SurrealityLabs/tn_vdp/KiCad/tn_vdp_v1_compact_vga_cable/tn_vdp_v1_compact_vga_cable.pdf

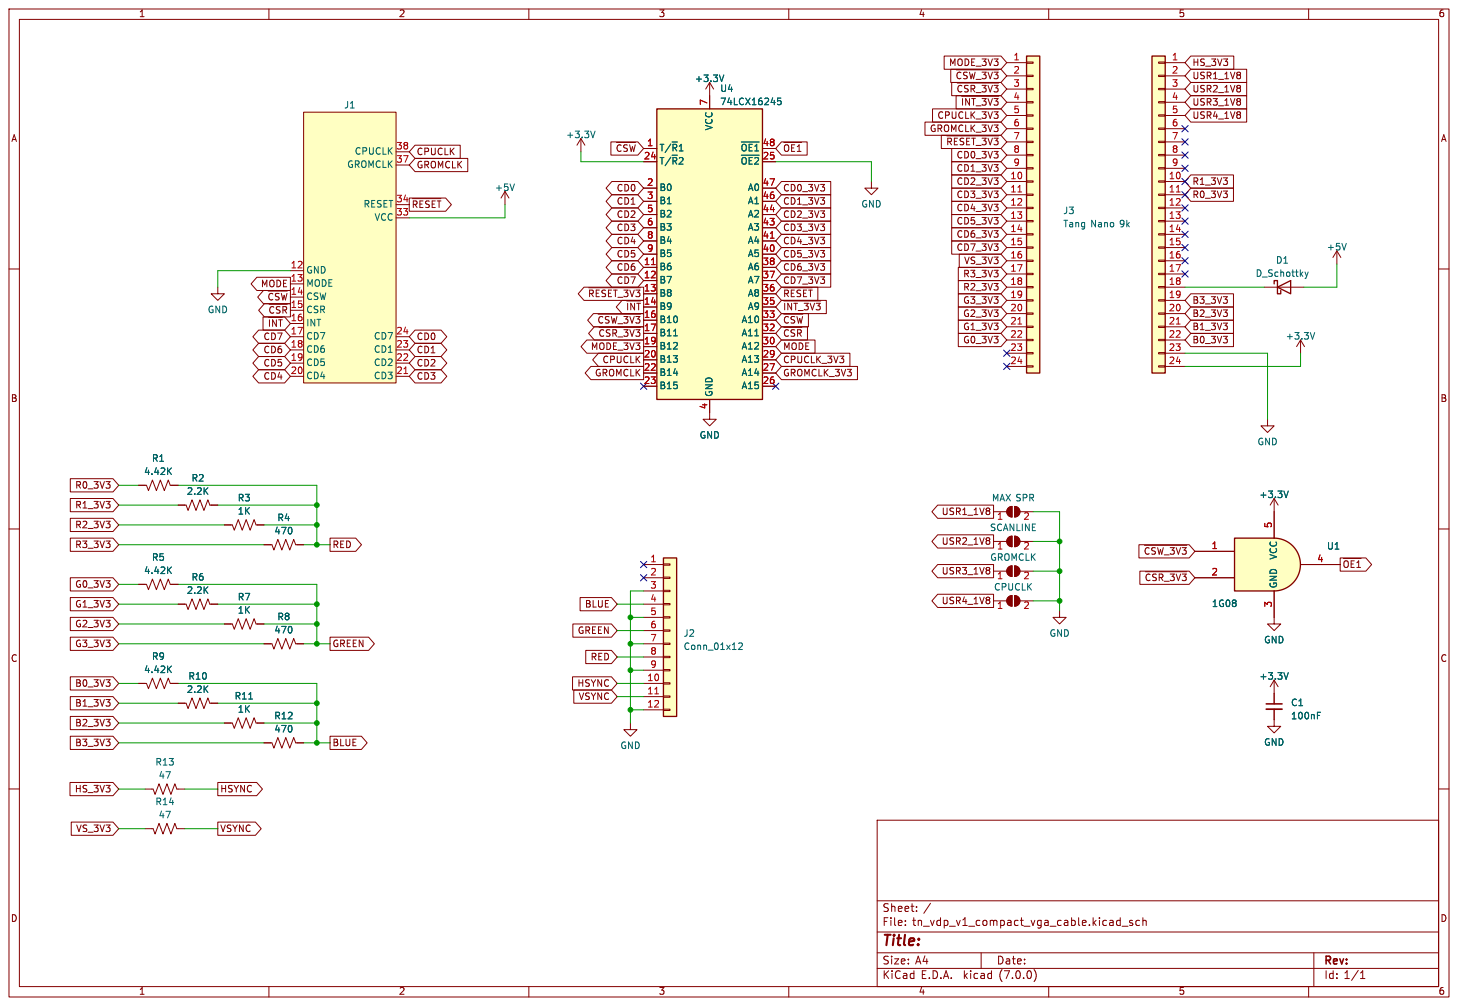
[picture p1: page 1]

Id: 1/1 Title: File: tn_vdp_v1_compact_vga_cable.kicad_sch Sheet: / R2
