SurrealityLabs/tn_vdp/KiCad/tn_vdp_v1_compact_vga_cable/tn_vdp_v1_compact_vga_cable.kicad_pcb

## KiCad design KiCad/tn_vdp_v1_compact_vga_cable/tn_vdp_v1_compact_vga_cable.kicad_pcb (2023-06-11)

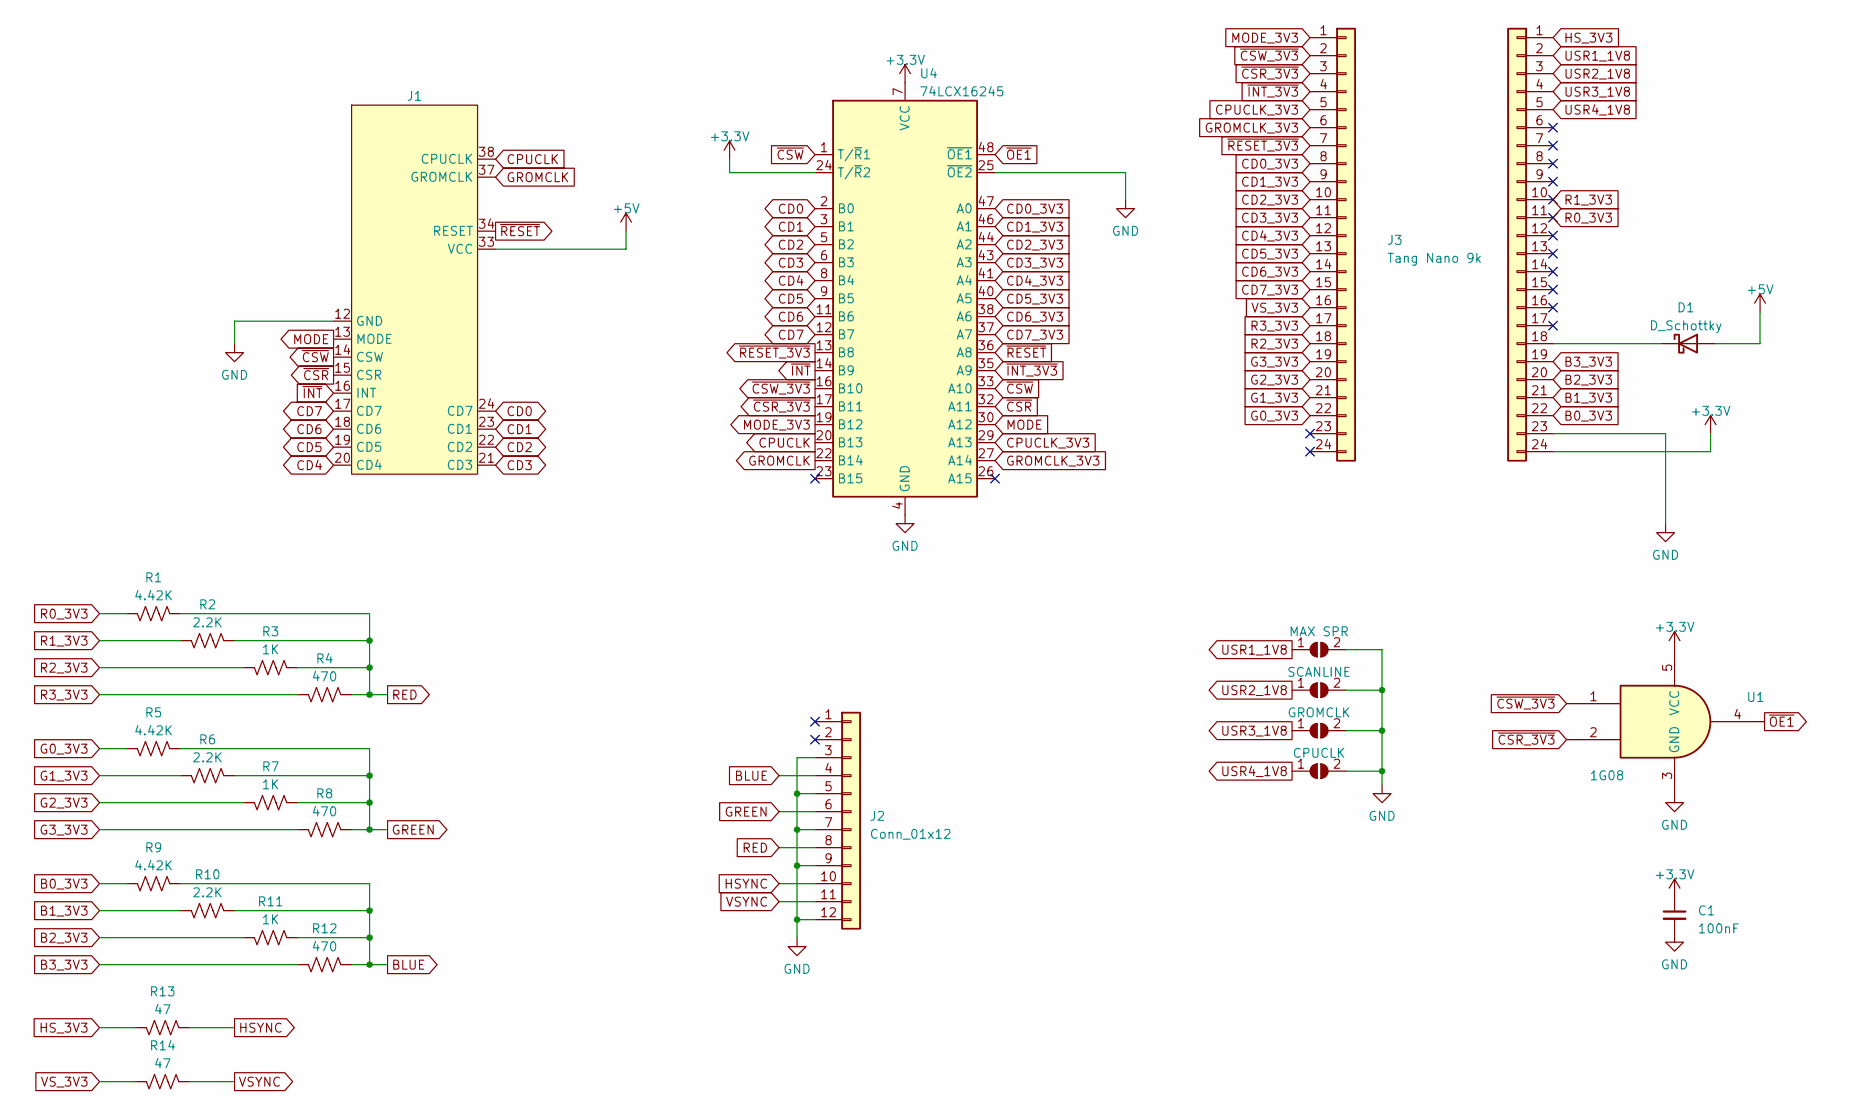
[picture p2: schematic tn_vdp_v1_compact_vga_cable.kicad_sch]

Parts:
C1: 100nF; C_0603_1608Metric_Pad1.08x0.95mm_HandSolder; LCSC C2857981
D1: D_Schottky; D_SOD-123; LCSC C2900723
J1: TMS99xxA_Replacement
J2: Conn_01x12; JST_PH_B12B-PH-K_1x12_P2.00mm_Vertical
J3: Tang Nano 9k; PinSocket_1x24_P2.54mm_Vertical
J4: TN9k/2; PinSocket_1x24_P2.54mm_Vertical
JP1: MAX SPR; SolderJumper-2_P1.3mm_Open_RoundedPad1.0x1.5mm
JP2: SCANLINE; SolderJumper-2_P1.3mm_Open_RoundedPad1.0x1.5mm
JP3: GROMCLK; SolderJumper-2_P1.3mm_Open_RoundedPad1.0x1.5mm
JP4: CPUCLK; SolderJumper-2_P1.3mm_Open_RoundedPad1.0x1.5mm
R1, R5, R9: 4.42K; R_0603_1608Metric_Pad0.98x0.95mm_HandSolder; LCSC C5140130
R2, R6, R10: 2.2K; R_0603_1608Metric_Pad0.98x0.95mm_HandSolder; LCSC C3016472
R3, R7, R11: 1K; R_0603_1608Metric_Pad0.98x0.95mm_HandSolder; LCSC C3016283
R4, R8, R12: 470; R_0603_1608Metric_Pad0.98x0.95mm_HandSolder; LCSC C103660
R13, R14: 47; R_0603_1608Metric_Pad0.98x0.95mm_HandSolder; LCSC C3016437
U1: 1G08; SOT-23-5_HandSoldering; LCSC C7666
U4: 74LCX16245; TSSOP-48_6.1x12.5mm_P0.5mm; LCSC C894789

Connections:
+3.3V: C1.1, J4.24, U1.5 (VCC), U4.7 (VCC), U4.18 (VCC), U4.24 (T/~R2), U4.31 (VCC), U4.42 (VCC)
+5V: D1.2 (A), J1.33 (VCC)
B0_3V3: J4.22, R9.2
B1_3V3: J4.21, R10.2
B2_3V3: J4.20, R11.2
B3_3V3: J4.19, R12.2
BLUE: J2.4, R9.1, R10.1, R11.1, R12.1
CD0: J1.24 (CD7), U4.2 (B0)
CD0_3V3: J3.8, U4.47 (A0)
CD1: J1.23 (CD1), U4.3 (B1)
CD1_3V3: J3.9, U4.46 (A1)
CD2: J1.22 (CD2), U4.5 (B2)
CD2_3V3: J3.10, U4.44 (A2)
CD3: J1.21 (CD3), U4.6 (B3)
CD3_3V3: J3.11, U4.43 (A3)
CD4: J1.20 (CD4), U4.8 (B4)
CD4_3V3: J3.12, U4.41 (A4)
CD5: J1.19 (CD5), U4.9 (B5)
CD5_3V3: J3.13, U4.40 (A5)
CD6: J1.18 (CD6), U4.11 (B6)
CD6_3V3: J3.14, U4.38 (A6)
CD7: J1.17 (CD7), U4.12 (B7)
CD7_3V3: J3.15, U4.37 (A7)
CPUCLK: J1.38 (CPUCLK), U4.20 (B13)
CPUCLK_3V3: J3.5, U4.29 (A13)
G0_3V3: J3.22, R5.2
G1_3V3: J3.21, R6.2
G2_3V3: J3.20, R7.2
G3_3V3: J3.19, R8.2
GND: C1.2, J1.12 (GND), J2.3, J2.5, J2.7, J2.9, J2.12, J4.23, JP1.2 (B), JP2.2 (B), JP3.2 (B), JP4.2 (B), U1.3 (GND), U4.4 (GND), U4.10 (GND), U4.15 (GND), U4.21 (GND), U4.25 (~OE2), U4.28 (GND), U4.34 (GND), U4.39 (GND), U4.45 (GND)
GREEN: J2.6, R5.1, R6.1, R7.1, R8.1
GROMCLK: J1.37 (GROMCLK), U4.22 (B14)
GROMCLK_3V3: J3.6, U4.27 (A14)
HSYNC: J2.10, R13.1
HS_3V3: J4.1, R13.2
MODE: J1.13 (MODE), U4.30 (A12)
MODE_3V3: J3.1, U4.19 (B12)
unnamed: D1.1 (K), J4.18
R0_3V3: J4.11, R1.2
R1_3V3: J4.10, R2.2
R2_3V3: J3.18, R3.2
R3_3V3: J3.17, R4.2
RED: J2.8, R1.1, R2.1, R3.1, R4.1
USR1_1V8: J4.2, JP1.1 (A)
USR2_1V8: J4.3, JP2.1 (A)
USR3_1V8: J4.4, JP3.1 (A)
USR4_1V8: J4.5, JP4.1 (A)
VSYNC: J2.11, R14.1
VS_3V3: J3.16, R14.2
~CSR_3V3: J3.3, U1.2, U4.17 (B11)
~CSR: J1.15 (CSR), U4.32 (A11)
~CSW_3V3: J3.2, U1.1, U4.16 (B10)
~CSW: J1.14 (CSW), U4.1 (T/~R1), U4.33 (A10)
~INT_3V3: J3.4, U4.35 (A9)
~INT: J1.16 (INT), U4.14 (B9)
~OE1: U1.4, U4.48 (~OE1)
~RESET_3V3: J3.7, U4.13 (B8)
~RESET: J1.34 (RESET), U4.36 (A8)

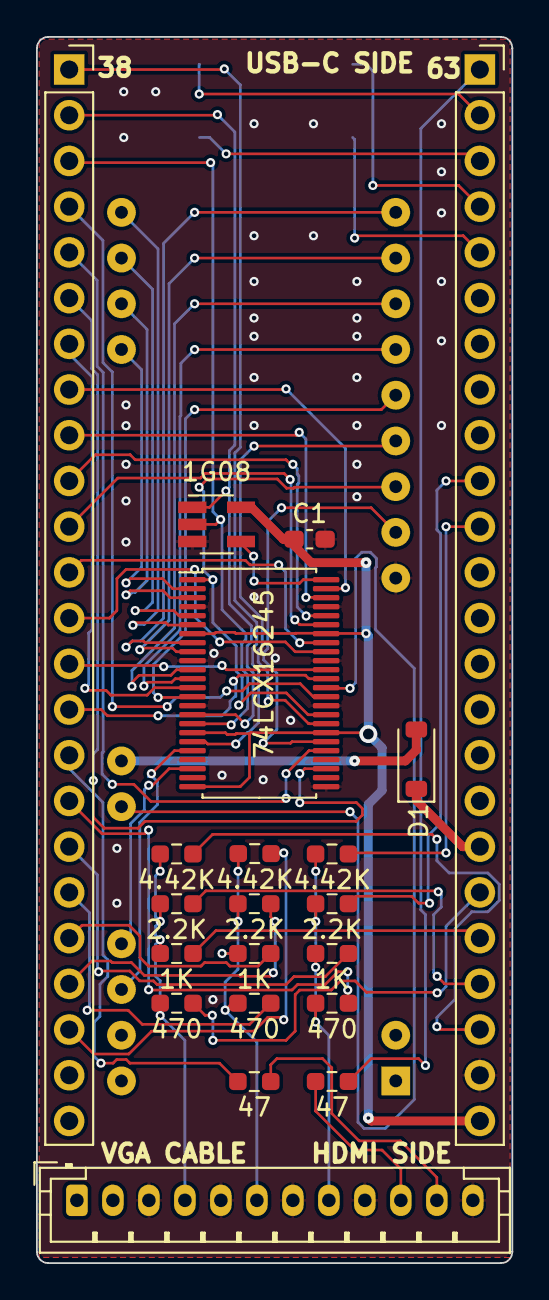
[picture p3: board tn_vdp_v1_compact_vga_cable.kicad_pcb from above]

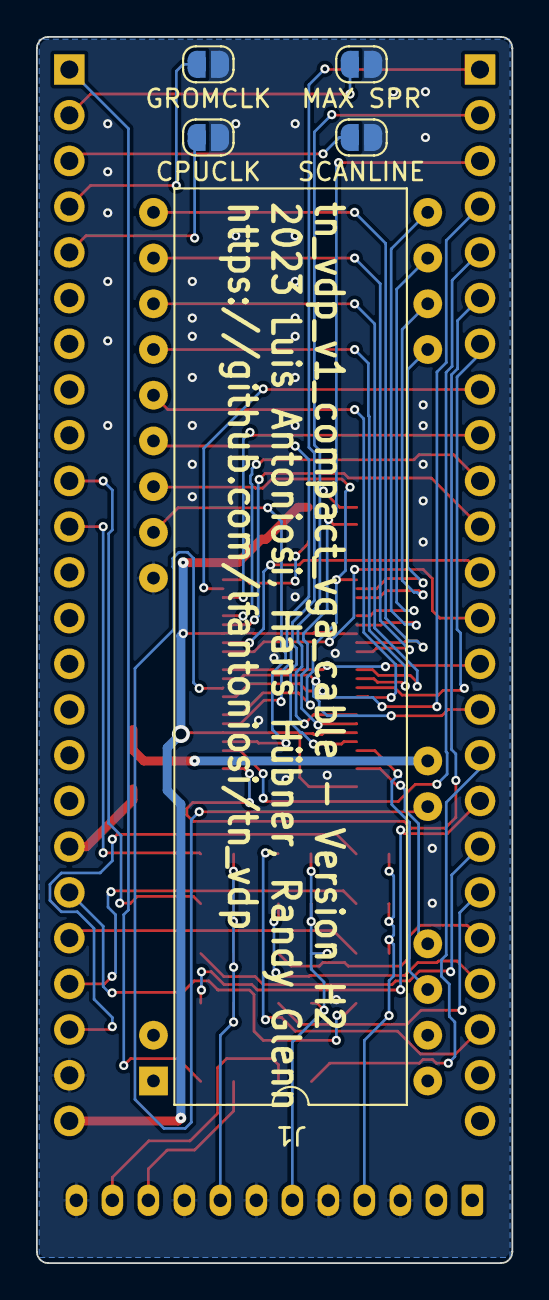
[picture p4: board tn_vdp_v1_compact_vga_cable.kicad_pcb from below]

Board: 2 copper layers, 26.4 x 68.1 mm, 26 parts (4 on the bottom side), 58 nets.
